CGrassin/cubesat_helmholtz_coils/README.md

# ECE3SAT - Helmholtz Coils

Resources for the Helmholtz coil cubesat magnetic environment simulator.

Article: https://charleslabs.fr/en/project-ECE3SAT+-+Helmholtz+Coils
