CGrassin/cubesat_helmholtz_coils/Mechanical/Clip.STEP

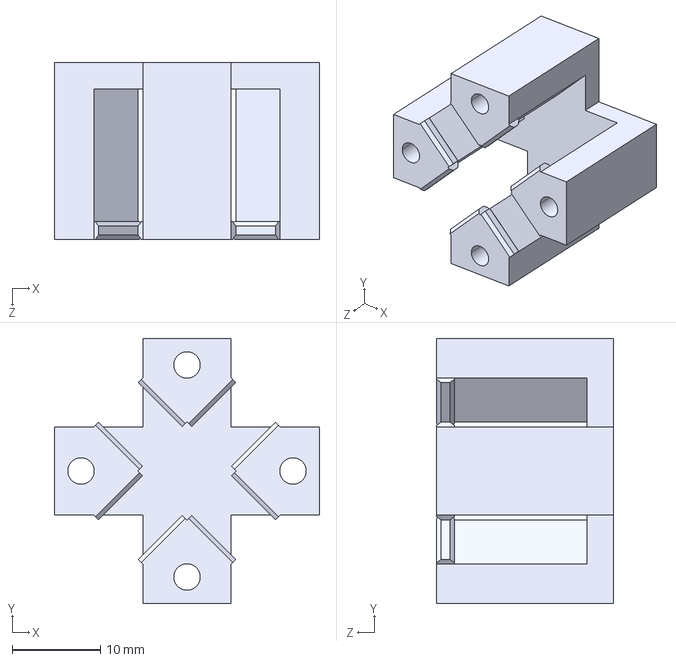
[picture p28: CAD file, 2026-04-08]
Mechanical/Clip.STEP
30.0 x 30.0 x 20.0 mm
