CGrassin/cubesat_helmholtz_coils/Mechanical/Cube/wheelS.SLDPRT

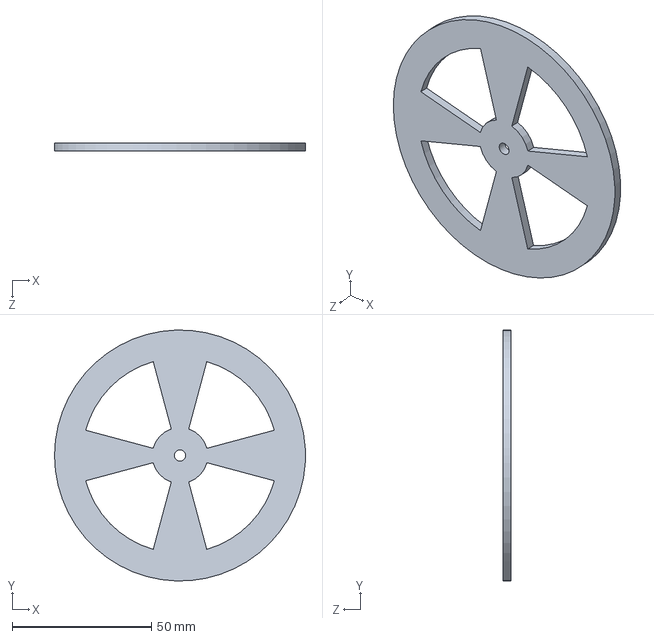
[picture p29: CAD file, 2026-04-08]
Mechanical/Cube/wheelS.SLDPRT
90.0 x 90.0 x 3.00 mm
