CGrassin/cubesat_helmholtz_coils/Mechanical/Cube/wheelXS.SLDPRT

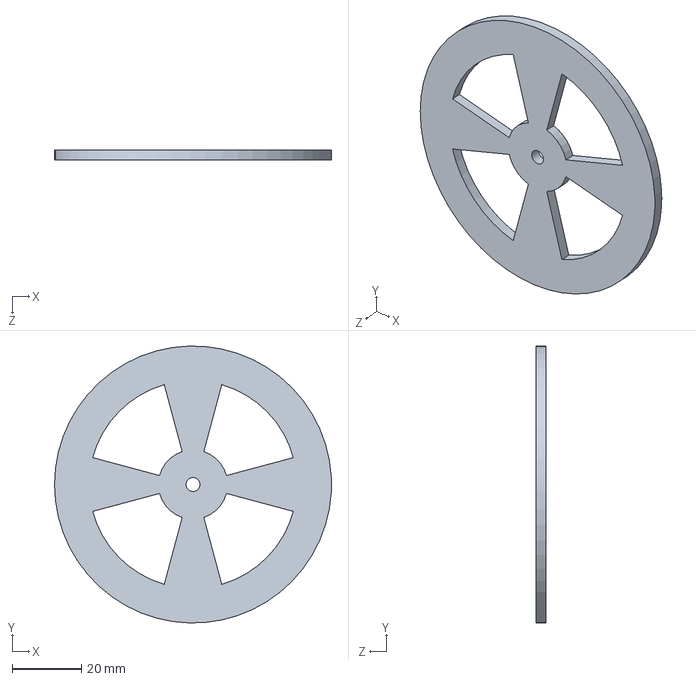
[picture p30: CAD file, 2026-04-08]
Mechanical/Cube/wheelXS.SLDPRT
80.0 x 80.0 x 3.00 mm
