CGrassin/cubesat_helmholtz_coils/Mechanical/Cube/Rail.SLDPRT

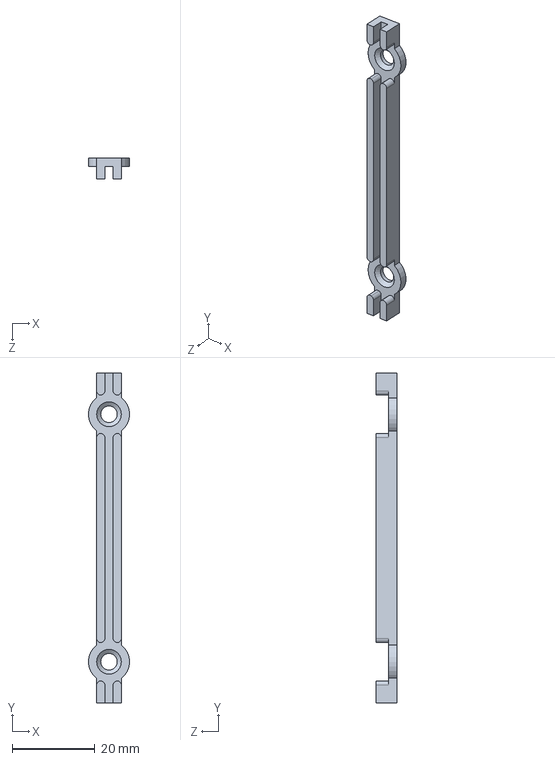
[picture p31: CAD file, 2026-04-08]
Mechanical/Cube/Rail.SLDPRT
10.0 x 80.0 x 5.00 mm
