CGrassin/cubesat_helmholtz_coils/Mechanical/Cube/Cube.STEP

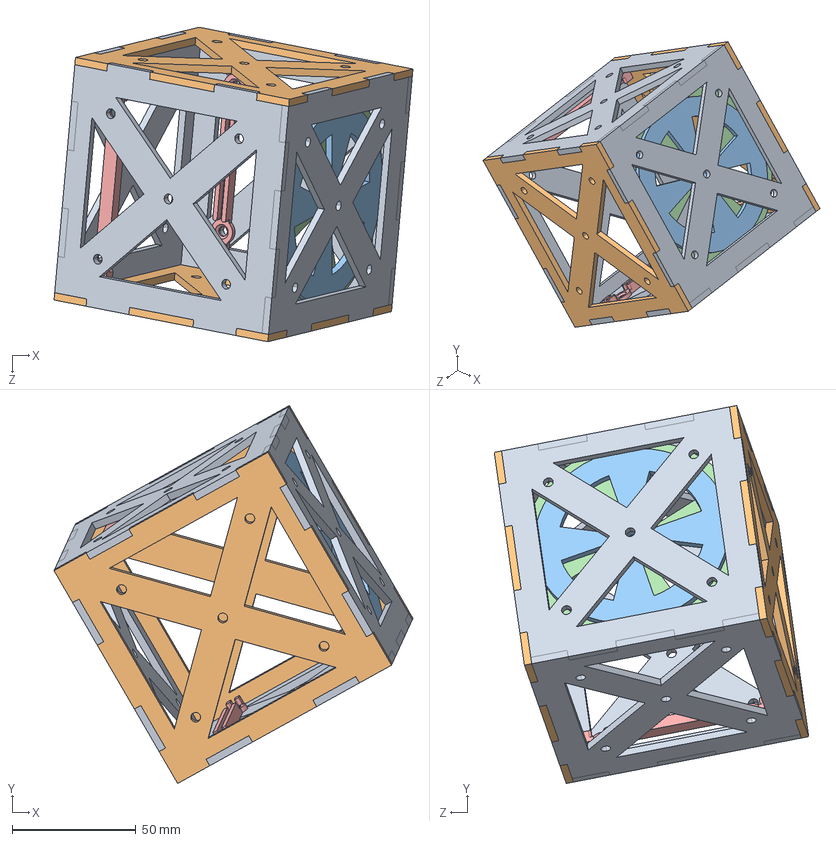
[picture p32: CAD file, 2026-04-08]
Mechanical/Cube/Cube.STEP
144.8 x 152.4 x 126.8 mm
CubeSide x 4
wheelXS
wheelS
Rail x 2
