CGrassin/cubesat_helmholtz_coils/Mechanical/Cube/CubeSide.SLDPRT

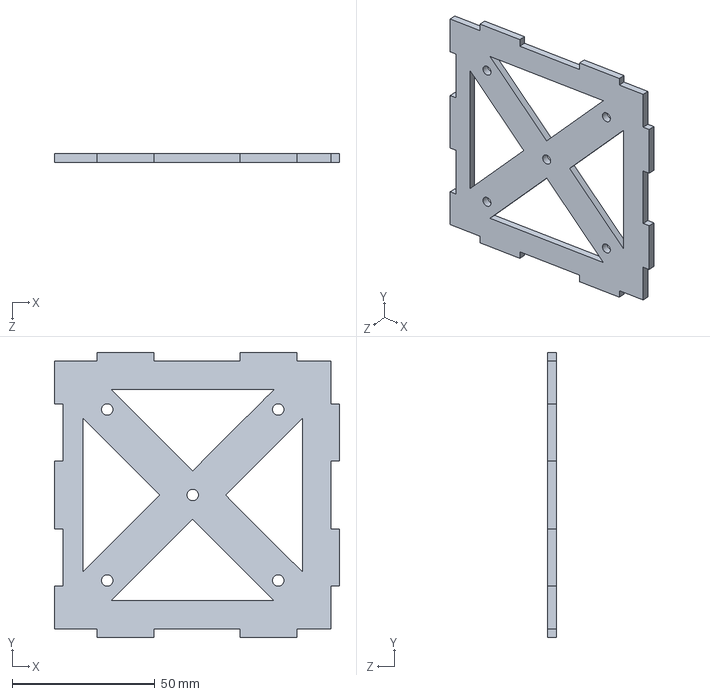
[picture p33: CAD file, 2026-04-08]
Mechanical/Cube/CubeSide.SLDPRT
100.0 x 100.0 x 3.00 mm
