CGrassin/cubesat_helmholtz_coils/(list of files, cad)

Other CAD files:
Mechanical/Clip.SLDPRT
Mechanical/Clip.STL
Mechanical/Cube/Cube.DXF
Mechanical/Cube/Cube.SLDASM
Mechanical/Cube/Cube.SLDPRT
Mechanical/Cube/CubeSide.DXF
Mechanical/Cube/wheelS.DXF
Mechanical/Cube/wheelXS.DXF
