CGrassin/cubesat_helmholtz_coils/Electronics/Hbridge/H-bridge.kicad_pcb

## KiCad design Electronics/Hbridge/H-bridge.kicad_pcb (2026-04-08)

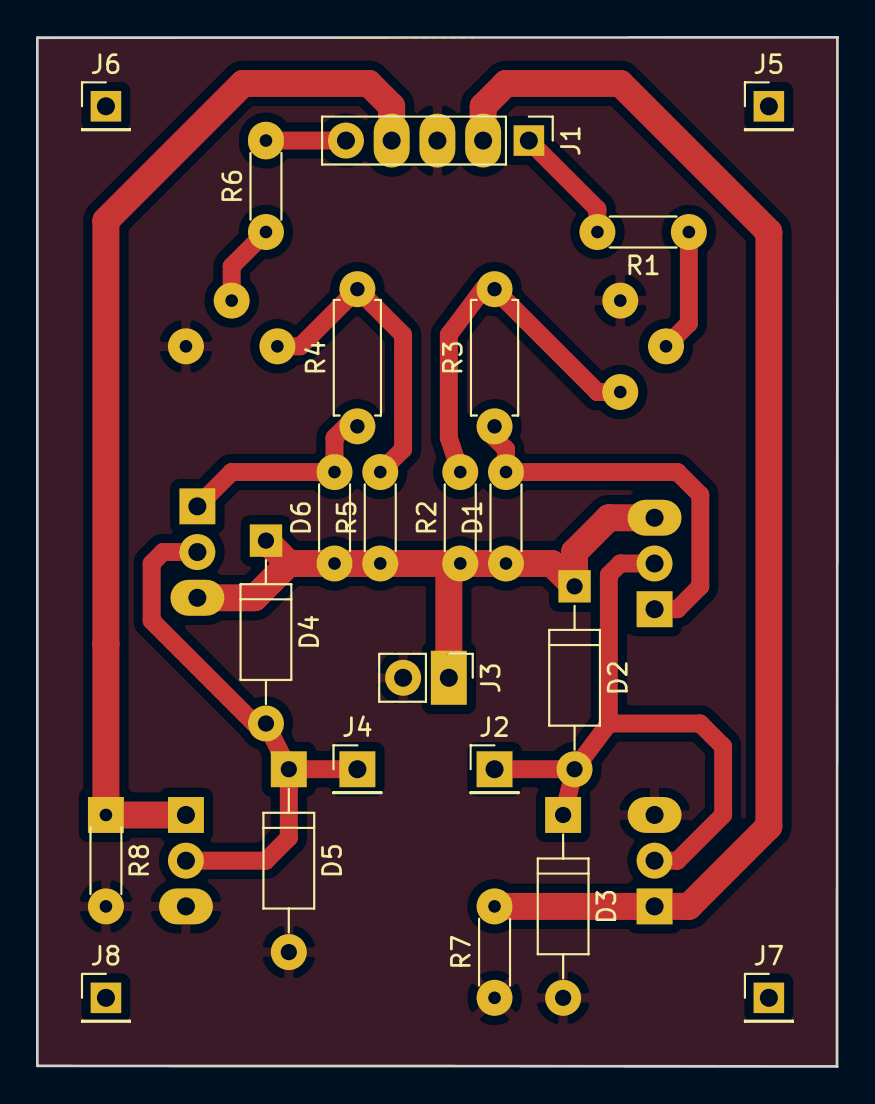
[picture p45: board H-bridge.kicad_pcb from above]

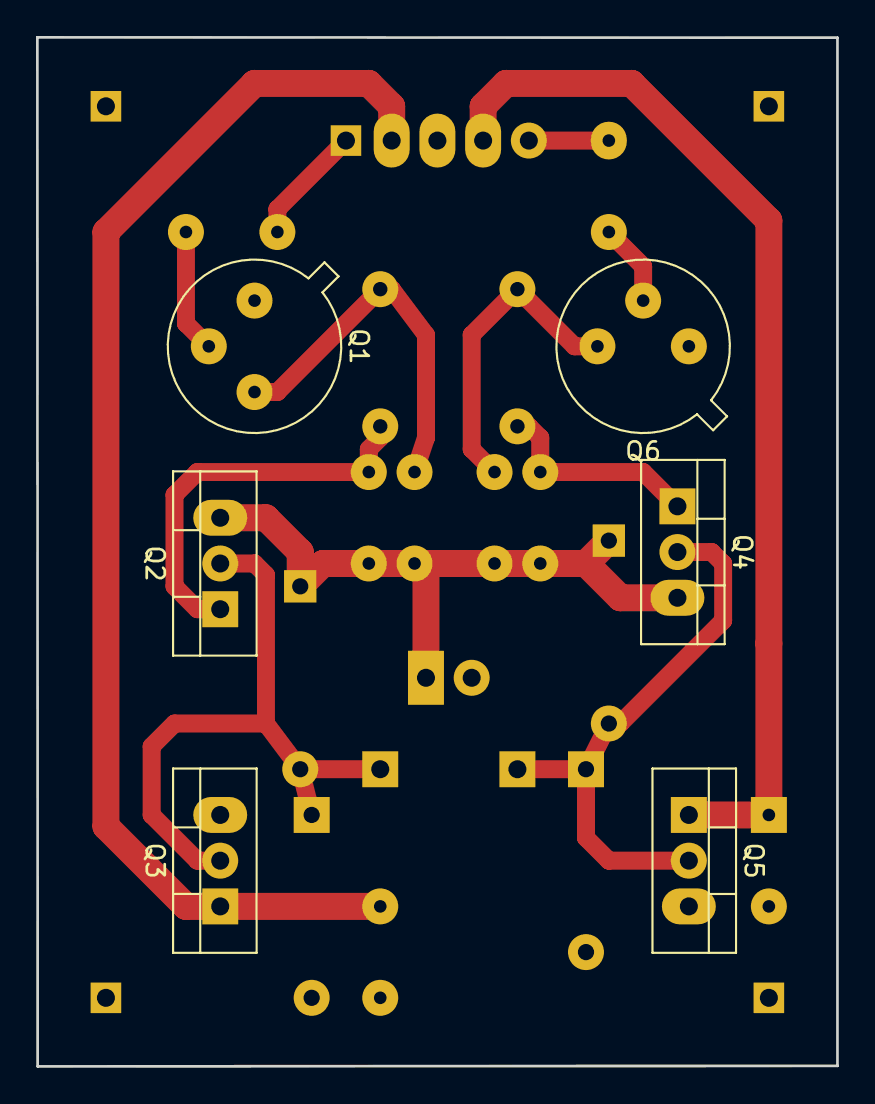
[picture p46: board H-bridge.kicad_pcb from below]

Board: 2 copper layers, 44.5 x 57.2 mm, 28 parts (6 on the bottom side), 14 nets.

Parts:
D1, D6: 10V; R_Axial_DIN0204_L3.6mm_D1.6mm_P5.08mm_Horizontal
D2, D3, D4, D5: 1N4007; D_A-405_P10.16mm_Horizontal
J1: Conn_01x05; Pin_Header_Straight_1x05_Pitch2.54mm
J2, J4, J5, J6, J7, J8: Conn_01x01; Pin_Header_Straight_1x01_Pitch2.54mm
J3: Conn_01x02; Pin_Header_Straight_1x02_Pitch2.54mm
Q1, Q6: BF259; TO-39-3_Window
Q2, Q4: FQP27P06; TO-220-3_Vertical
Q3, Q5: FQP13N10; TO-220-3_Vertical
R1, R6: 1k; R_Axial_DIN0204_L3.6mm_D1.6mm_P5.08mm_Horizontal
R2, R5: 10k; R_Axial_DIN0204_L3.6mm_D1.6mm_P5.08mm_Horizontal
R3, R4: 4k7; R_Axial_DIN0207_L6.3mm_D2.5mm_P7.62mm_Horizontal
R7, R8: 100k; R_Axial_DIN0204_L3.6mm_D1.6mm_P5.08mm_Horizontal

Connections:
GND: D3.2, D5.2, J1.3, J3.2, Q1.1, Q3.3, Q5.3, Q6.1, R7.1, R8.2
N_A: J1.4, Q5.1, R8.1
N_B: J1.2, Q3.1, R7.2
unnamed: D1.2, Q2.1, R3.1
unnamed: D2.2, D3.1, J2.1, Q2.2, Q3.2
unnamed: D4.2, D5.1, J4.1, Q4.2, Q5.2
unnamed: D6.2, Q4.1, R4.1
unnamed: Q1.2, R1.1
unnamed: Q1.3, R2.2, R3.2
unnamed: Q6.2, R6.1
unnamed: Q6.3, R4.2, R5.2
P_A: J1.1, R1.2
P_B: J1.5, R6.2
VDC: D1.1, D2.1, D4.1, D6.1, J3.1, Q2.3, Q4.3, R2.1, R5.1
