CGrassin/cubesat_helmholtz_coils/Electronics/carte_logique/carte_logique.kicad_pcb

## KiCad design Electronics/carte_logique/carte_logique.kicad_pcb (2026-04-08)

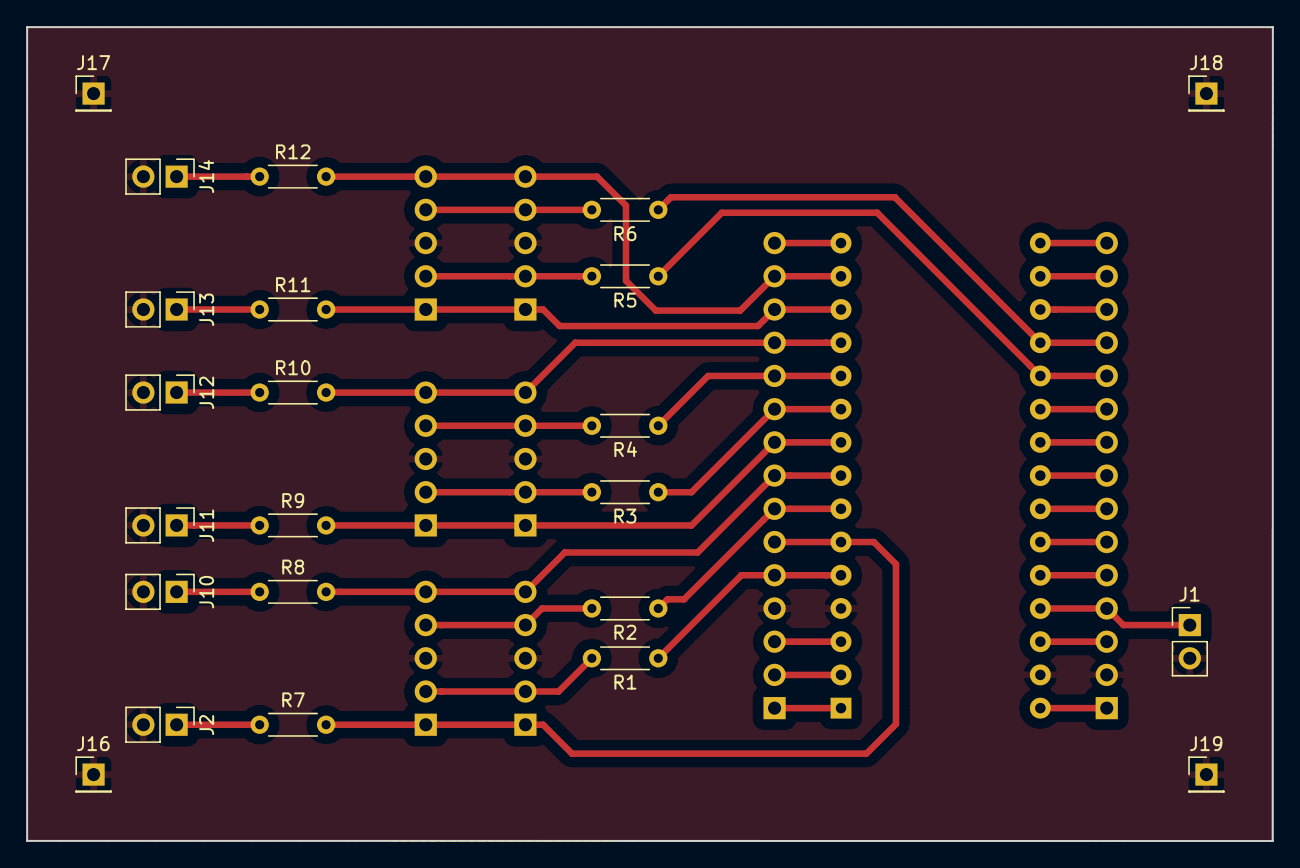
[picture p47: board carte_logique.kicad_pcb from above]

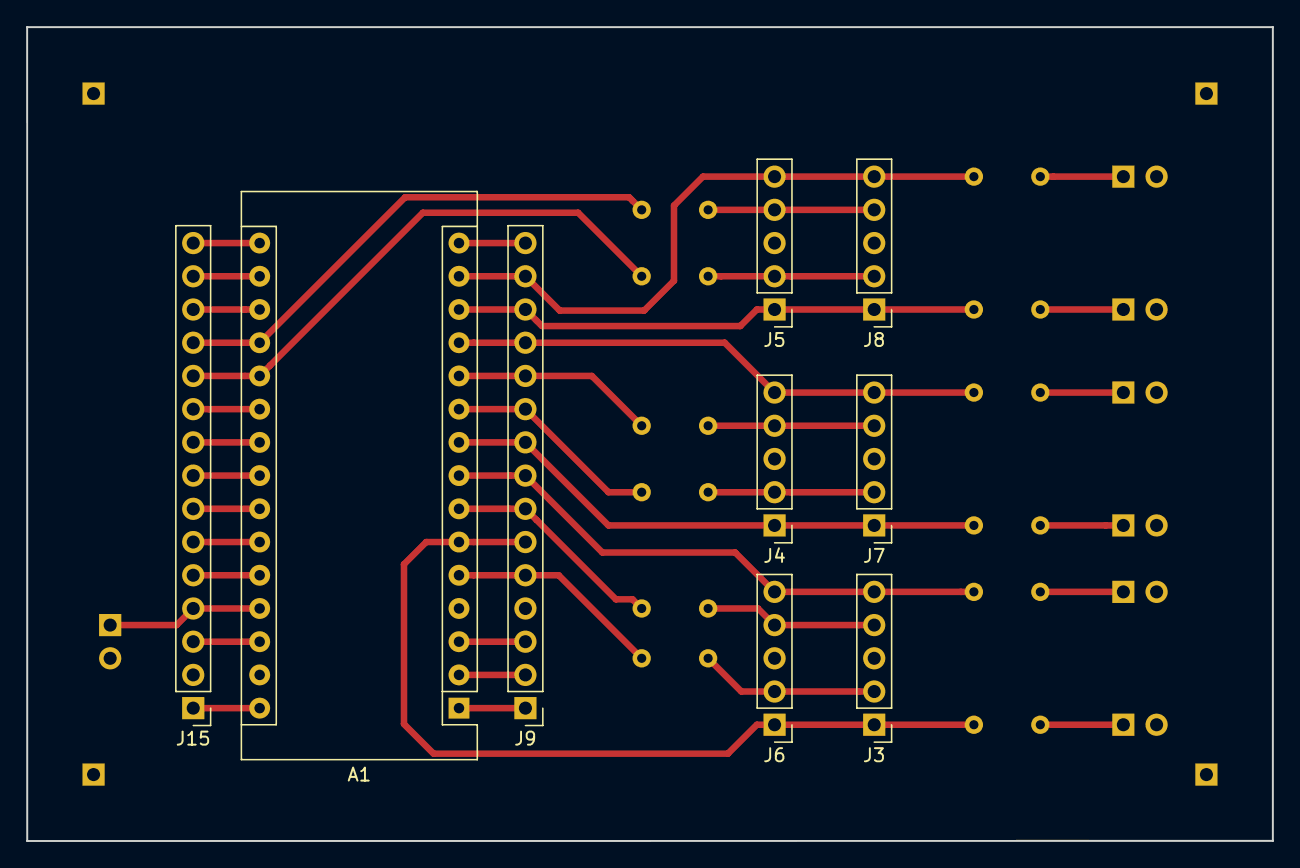
[picture p48: board carte_logique.kicad_pcb from below]

Board: 2 copper layers, 95.2 x 62.2 mm, 32 parts (9 on the bottom side), 41 nets.

Parts:
A1: Arduino_Nano_v3.x; Arduino_Nano
J1, J2, J10, J11, J12, J13, J14: Conn_01x02; Pin_Header_Straight_1x02_Pitch2.54mm
J3, J4, J5, J6, J7, J8: Conn_01x05; Pin_Header_Straight_1x05_Pitch2.54mm
J9, J15: Conn_01x15; Pin_Header_Straight_1x15_Pitch2.54mm
J16, J17, J18, J19: Conn_01x01; Pin_Header_Straight_1x01_Pitch2.54mm
R1, R2, R3, R4, R5, R6: 100; R_Axial_DIN0204_L3.6mm_D1.6mm_P5.08mm_Horizontal
R7, R8, R9, R10, R11, R12: R; R_Axial_DIN0204_L3.6mm_D1.6mm_P5.08mm_Horizontal

Connections:
/3.3V: A1.17, J15.14
/A0: A1.19, J15.12, R6.1
/A1: A1.20, J15.11, R5.1
/A2: A1.21, J15.10
/A3: A1.22, J15.9
/A4: A1.23, J15.8
/A5: A1.24, J15.7
/A6: A1.25, J15.6
/A7: A1.26, J15.5
/D2: A1.5, J9.5, R1.1
/D3: A1.6, J3.1, J6.1, J9.6, R7.2
/D4: A1.7, J9.7, R2.1
/D5: A1.8, J3.5, J6.5, J9.8, R8.2
/D6: A1.9, J4.1, J7.1, J9.9, R9.2
/D7: A1.10, J9.10, R3.1
/D8: A1.11, J9.11, R4.1
/D9: A1.12, J4.5, J7.5, J9.12, R10.2
/D10: A1.13, J5.1, J8.1, J9.13, R11.2
/D11: A1.14, J5.5, J8.5, J9.14, R12.2
/D12: A1.15, J9.15
/D13: A1.16, J15.15
/REF: A1.18, J15.13
/RST0: A1.3, J9.3
/RST1: A1.28, J15.3
/RX: A1.2, J9.2
/TX: A1.1, J9.1
/VIN: A1.30, J15.1
GND: A1.4, A1.29, J1.2, J2.2, J3.3, J4.3, J5.3, J6.3, J7.3, J8.3, J9.4, J10.2, J11.2, J12.2, J13.2, J14.2, J15.2, J16.1, J17.1, J18.1, J19.1
unnamed: J2.1, R7.1
unnamed: J3.2, J6.2, R1.2
unnamed: J3.4, J6.4, R2.2
unnamed: J4.2, J7.2, R3.2
unnamed: J4.4, J7.4, R4.2
unnamed: J5.2, J8.2, R5.2
unnamed: J5.4, J8.4, R6.2
unnamed: J10.1, R8.1
unnamed: J11.1, R9.1
unnamed: J12.1, R10.1
unnamed: J13.1, R11.1
unnamed: J14.1, R12.1
VCC: A1.27, J1.1, J15.4
